suupen/MDX-20Controler/README.md

# MDX-20Controler
standalone controler for MDX-15/20(lorand cnc)

EPS32 module　を使用した MDX-20(lorand CNC)コントローラソフトです。
