suupen/MDX-20Controler/document/PCB/部品面.pdf

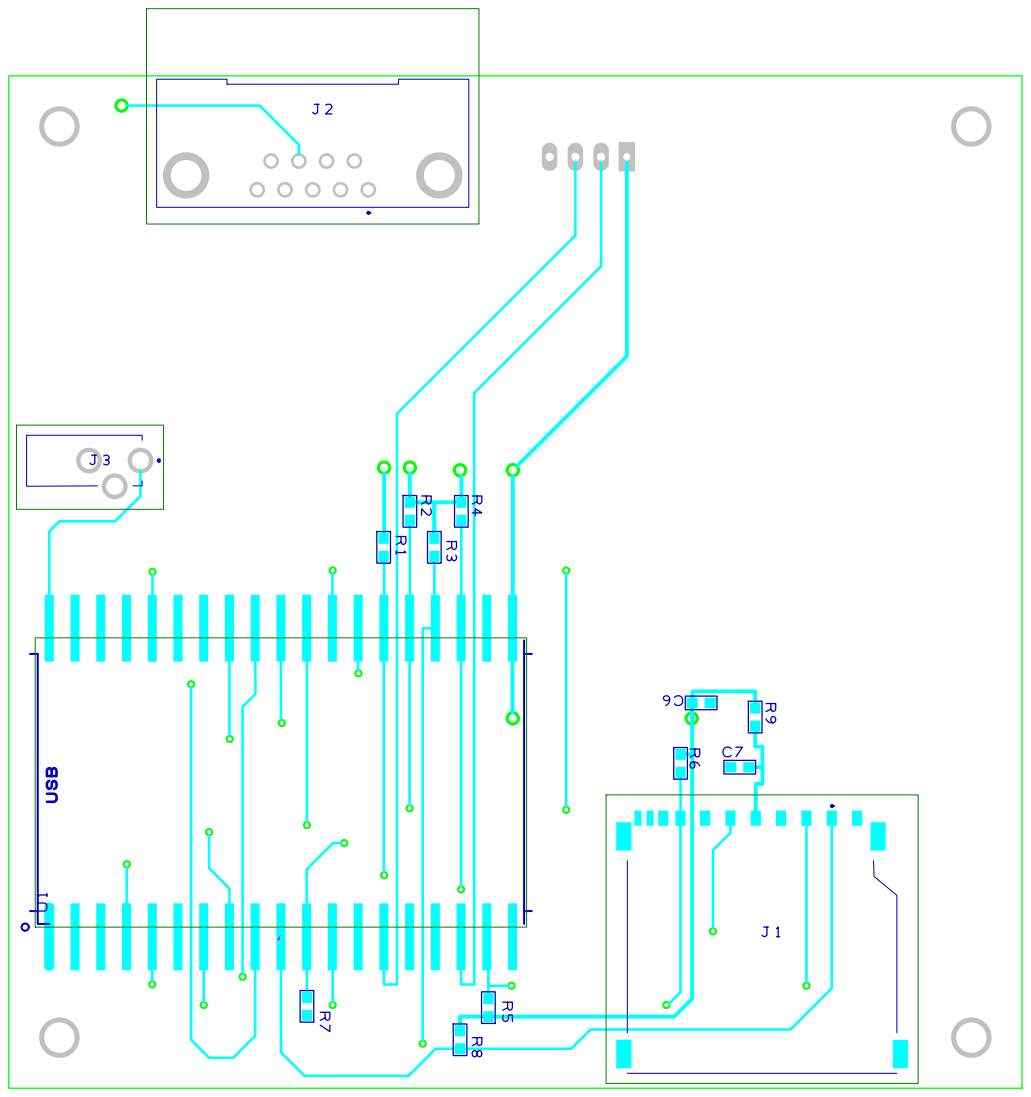
[picture p7: page 1]
