suupen/MDX-20Controler/document/PCB/MDX20controler_auto - PCB.pdf

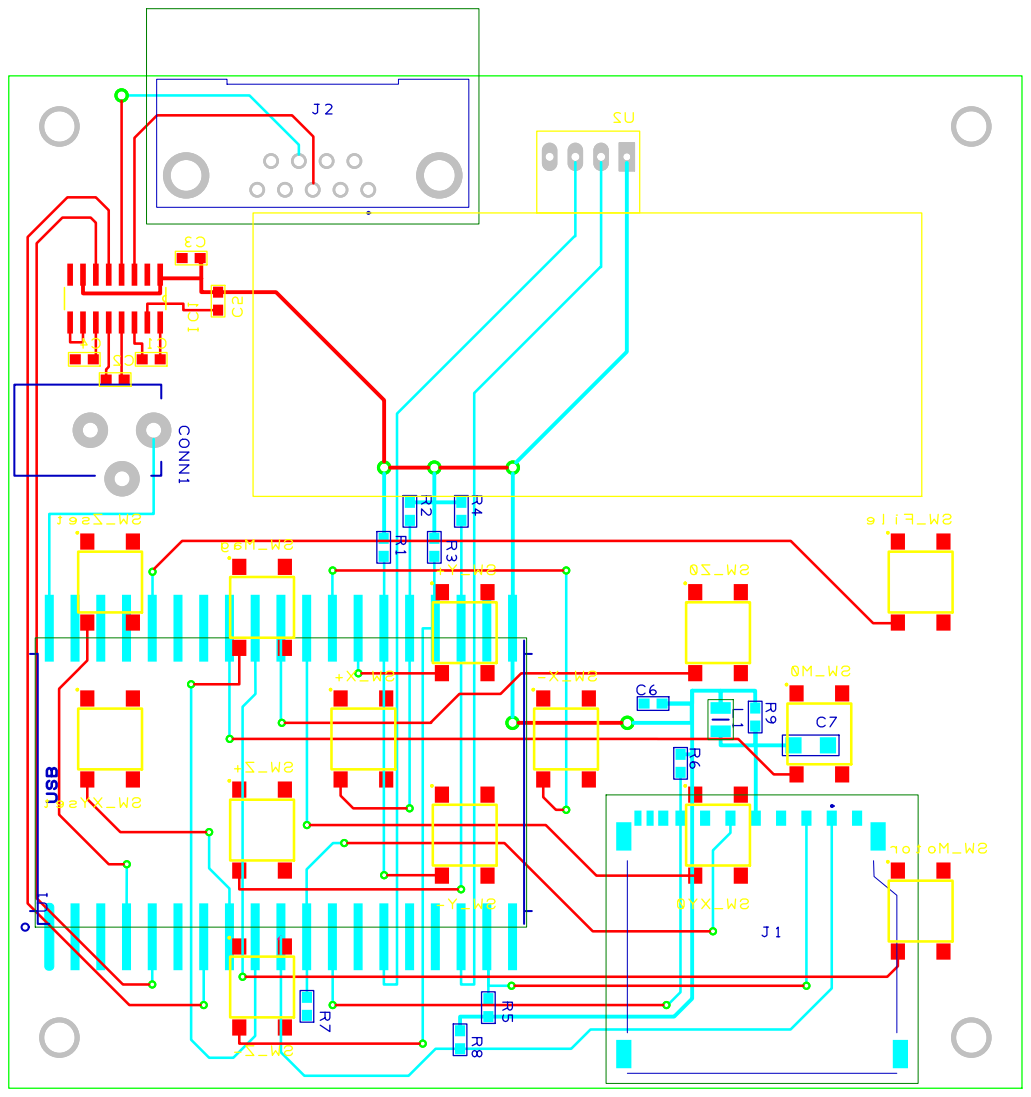
[picture p8: page 1]
