suupen/MDX-20Controler/document/PCB/両面.pdf

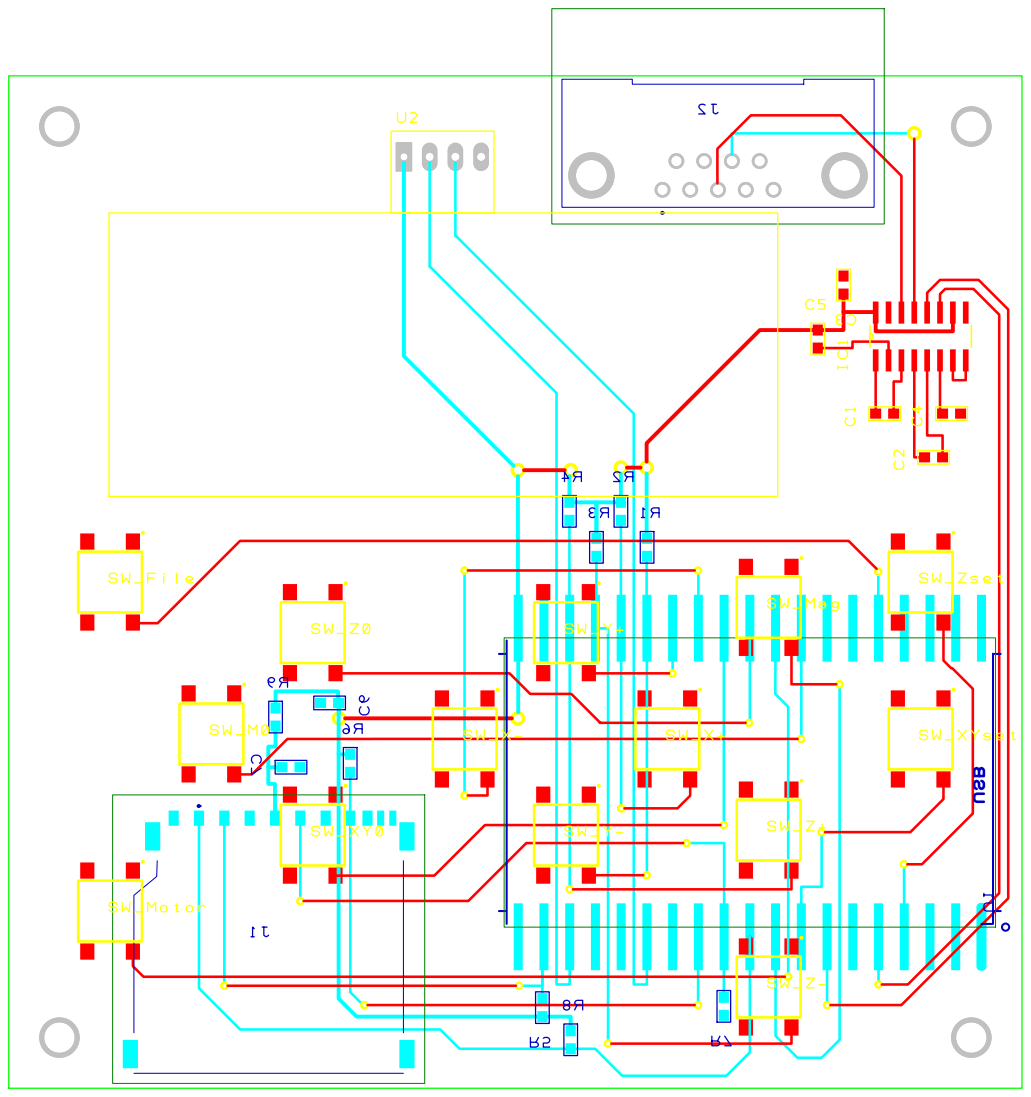
[picture p9: page 1]
