suupen/MDX-20Controler/document/PCB/半田面.pdf

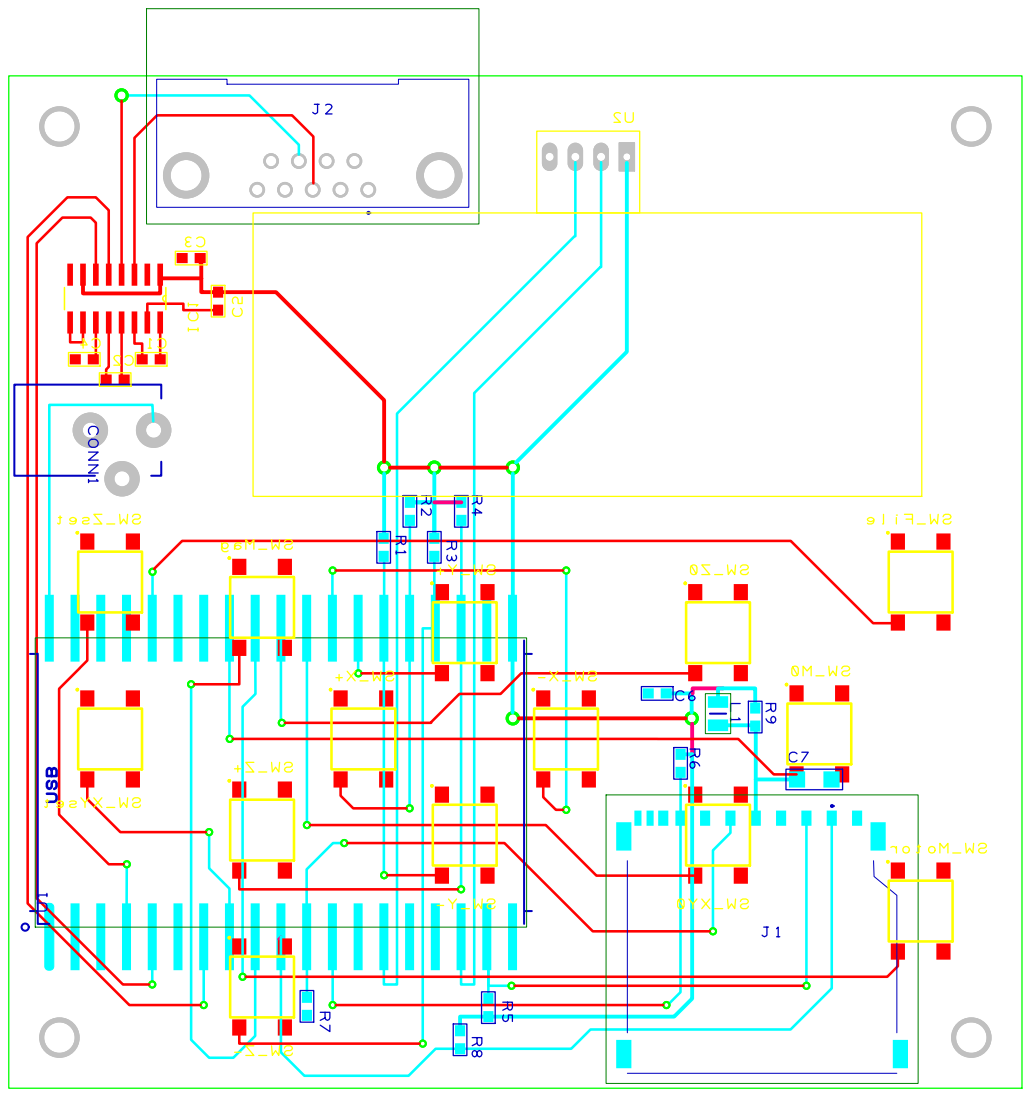
[picture p10: page 1]
