suupen/MDX-20Controler/(list of files, drawings)

Other design files:
document/PCB/MDX20controler_auto.pcb
document/PCB/P190113a発注/MDX20controler_auto.pcb
document/PCB/P190113a発注/~MDX20controler_auto.pcb
document/PCB/~MDX20controler_auto.pcb
