suupen/MDX-20Controler/src/mbedTypedef.h

#ifndef MBED_TYPEDEF_H
#define MBED_TYPEDEF_H

typedef unsigned char uint8_t;
typedef char int8_t;

typedef unsigned short	uint16_t;
typedef short	int16_t;

typedef unsigned int	uint32_t;
typedef int	int32_t;
typedef unsigned long long	uint64_t;
typedef long long	int64_t;


#endif // MBED_TYPEDEF_H
